paulodowd/RoboticsScienceAndSystems/README.md

# RoboticsScienceAndSystems
Platforms for teaching Robotics Science and Systems
