paulodowd/RoboticsScienceAndSystems/DigitalTwin/surface2.png

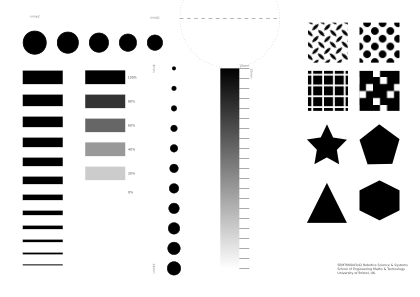
DigitalTwin/surface2.png
