paulodowd/RoboticsScienceAndSystems/DigitalTwin/surface.png

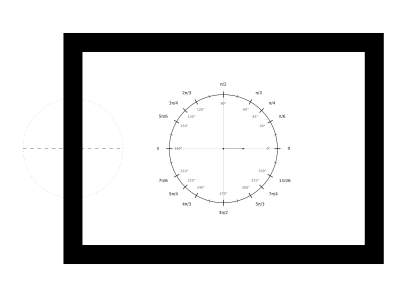
DigitalTwin/surface.png
