paulodowd/RoboticsScienceAndSystems/pcb/RSS_StampC3Extension/M5_Hardware-master/Products/K132_Cardputer/Structures/Cardputer_Button.stl

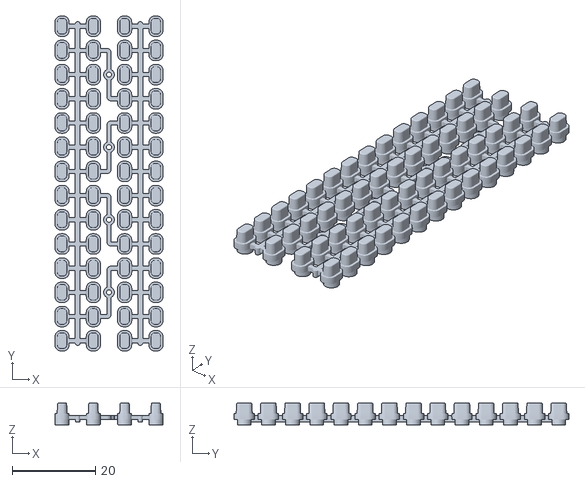
[picture p3: CAD file, 2026-10-30]
pcb/RSS_StampC3Extension/M5_Hardware-master/Products/K132_Cardputer/Structures/Cardputer_Button.stl
25.9 x 80.3 x 5.25
