paulodowd/RoboticsScienceAndSystems/pcb/RSS_StampC3Extension/RSS_StampC3Extension.pdf

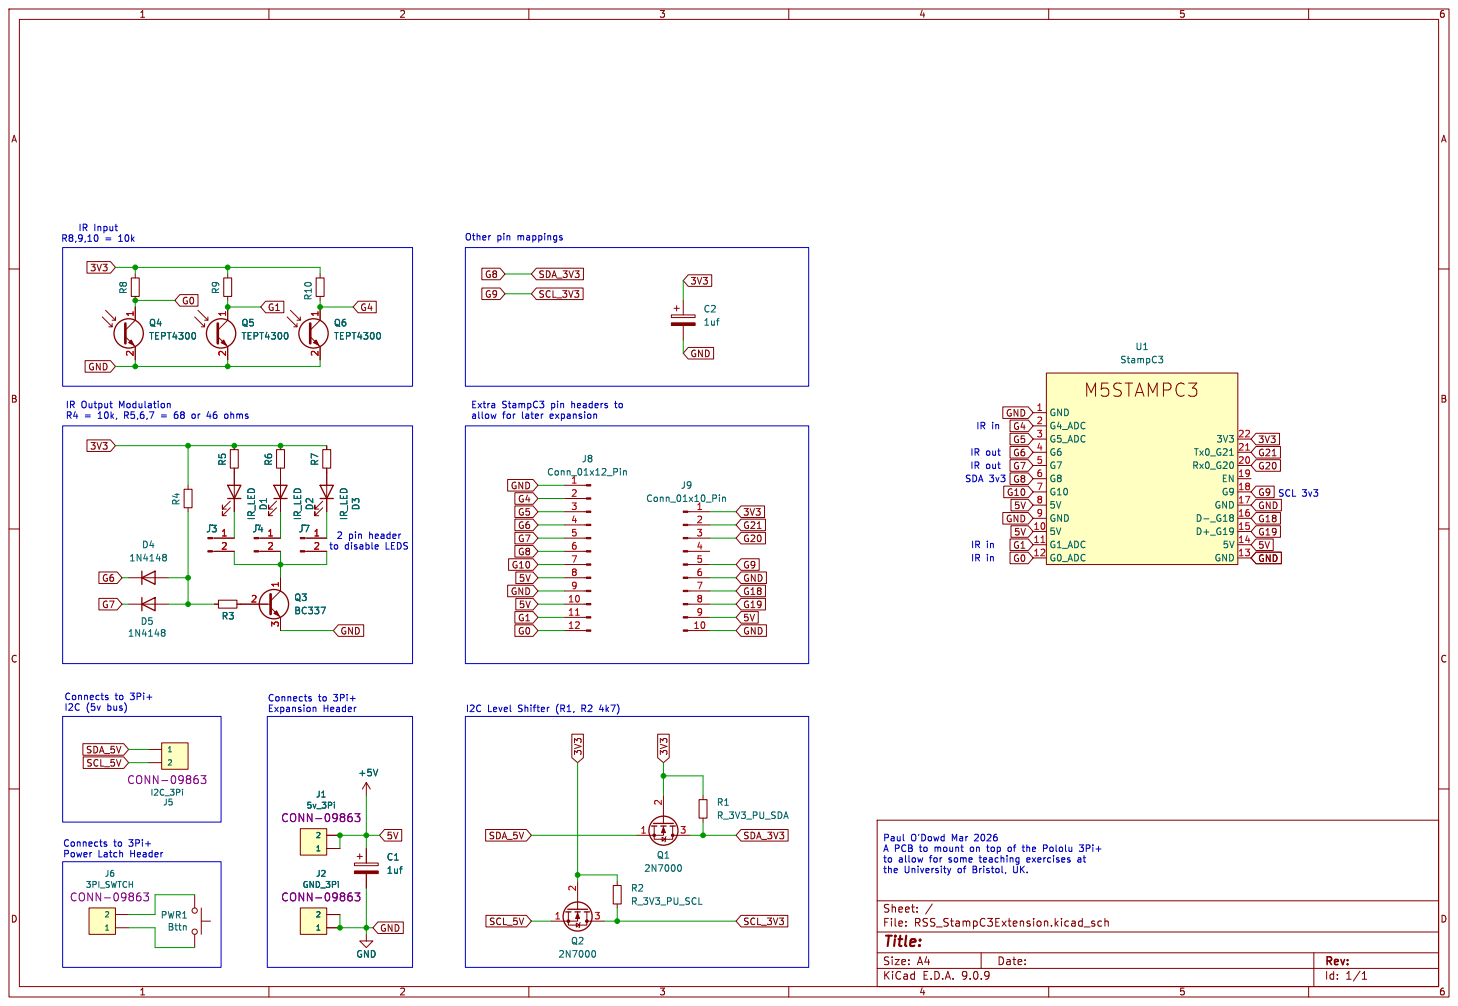
[picture p4: page 1]

IR Input R8,9,10 = 10k Connects to 3Pi+ Power Latch Header Connects to 3Pi+
3V3 SCL_5V

IR Output Modulation R4 = 10k, R5,6,7 = 68 or 46 ohms

IR out Extra StampC3 pin headers to
allow for later expansion

Id: 1/1 Title: File: RSS_StampC3Extension.kicad_sch Sheet: / +5V D1 IR_LED

IR in Paul O'Dowd Mar 2026 A PCB to mount on top of the Pololu 3Pi+
