paulodowd/RoboticsScienceAndSystems/(list of files, drawings)

Other design files:
pcb/RSS_StampC3Extension/M5_Hardware-master/Common/Module13.2/Footprints/Module13.2_Proto_Board.PcbDoc
pcb/RSS_StampC3Extension/M5_Hardware-master/Common/Module_Type_A/Footprints/Module_Type_A_CoreS3_M5_Bus.PcbDoc
pcb/RSS_StampC3Extension/M5_Hardware-master/Products/M001_Module_Proto/Footprints/Module_Proto_Board.PcbDoc
pcb/RSS_StampC3Extension/M5_Hardware-master/Products/S015_Stamp-S3Bat/Footprint/Stamp-S3Bat_SMD.PcbDoc
