paulodowd/RoboticsScienceAndSystems/pcb/RSS_StampC3Extension/RSS_StampC3Extension.kicad_pcb

## KiCad design pcb/RSS_StampC3Extension/RSS_StampC3Extension.kicad_pcb (2026-10-30)

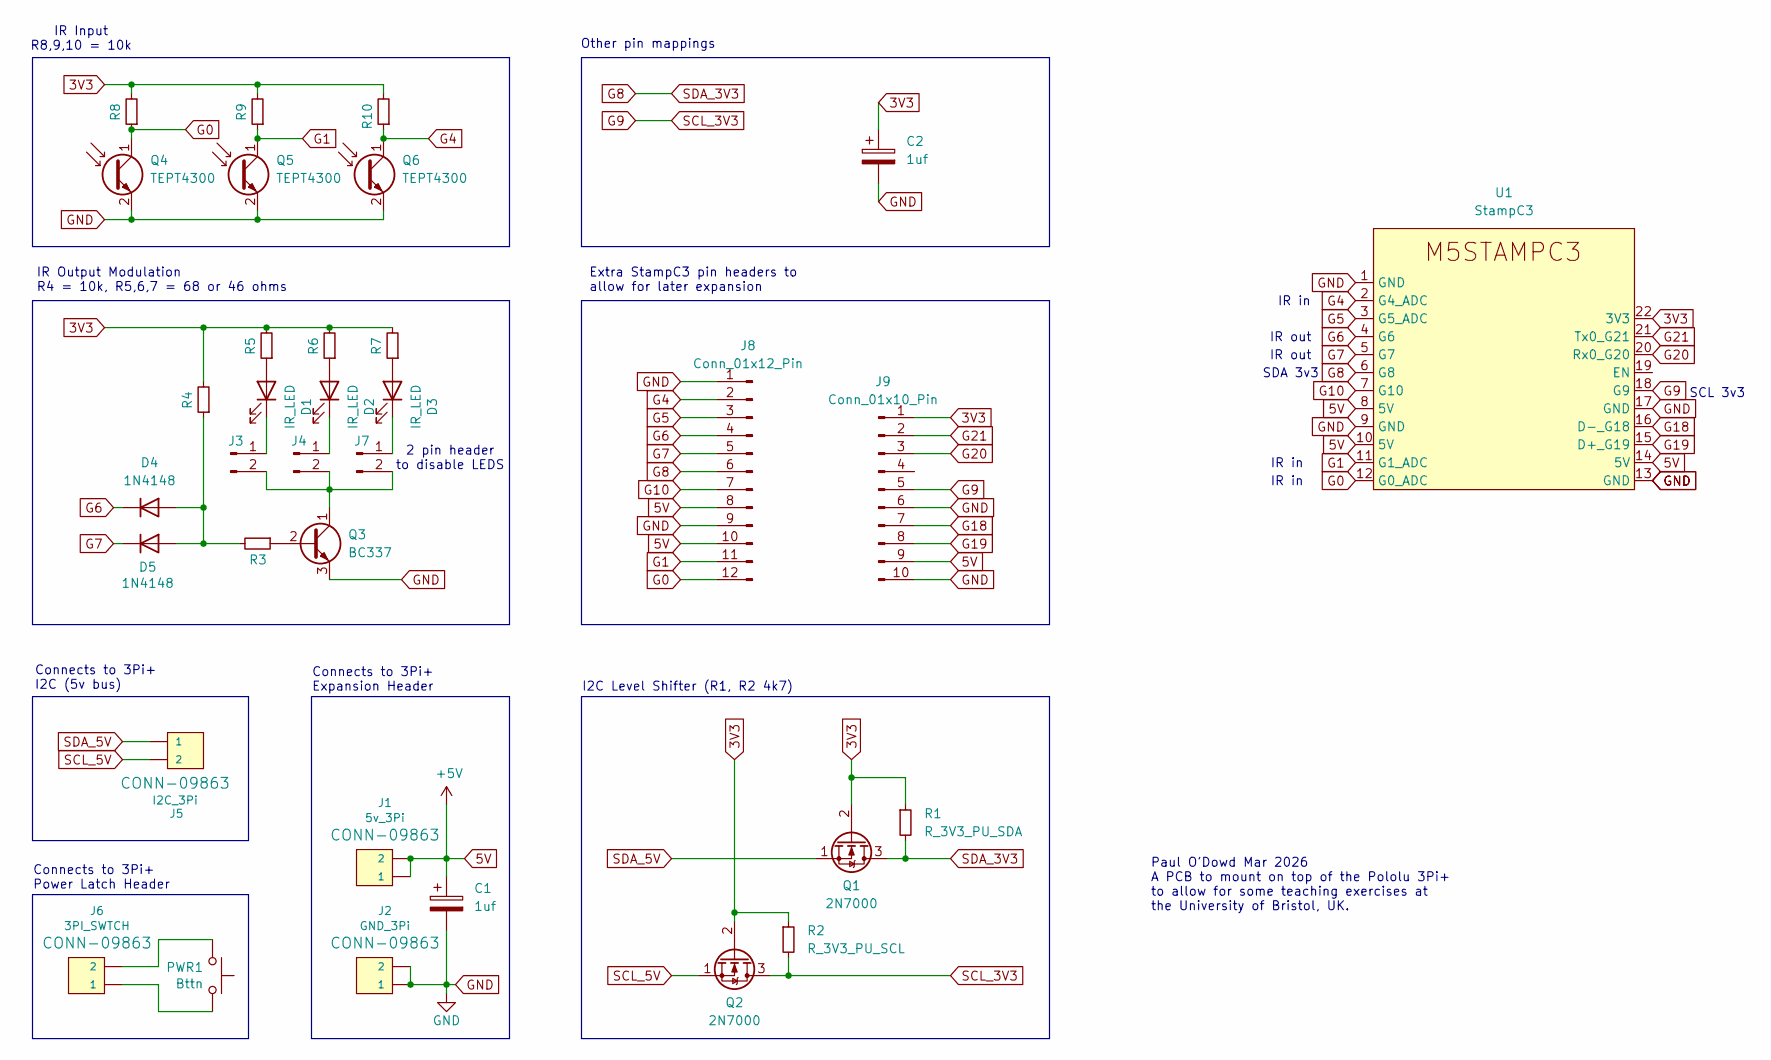
[picture p5: schematic RSS_StampC3Extension.kicad_sch]

Parts:
C1, C2: 1uf; CP_Radial_D5.0mm_P2.00mm
D1, D2, D3: IR_LED; LED_D3.0mm_Horizontal_O1.27mm_Z2.0mm
D4, D5: 1N4148; D_DO-35_SOD27_P7.62mm_Horizontal
J1: 5v_3Pi; PinHeader_1x02_P2.54mm_Vertical
J2: GND_3Pi; PinHeader_1x02_P2.54mm_Vertical
J3, J4, J7: PinHeader_1x02_P2.54mm_Vertical
J5: I2C_3Pi; PinHeader_1x02_P2.54mm_Vertical
J6: 3PI_SWTCH; PinHeader_1x02_P2.54mm_Vertical
J8: Conn_01x12_Pin; PinHeader_1x12_P2.54mm_Vertical
J9: Conn_01x10_Pin; PinHeader_1x10_P2.54mm_Vertical
PWR1: Bttn; SW_PUSH_6mm
Q1, Q2: 2N7000; TO-92_Inline
Q3: BC337; TO-92_Inline
Q4, Q5, Q6: TEPT4300; LED_D3.0mm_Clear
R1: R_3V3_PU_SDA; R_Axial_DIN0207_L6.3mm_D2.5mm_P10.16mm_Horizontal
R2: R_3V3_PU_SCL; R_Axial_DIN0207_L6.3mm_D2.5mm_P10.16mm_Horizontal
R3, R4, R5, R6, R7, R8, R9, R10: R_Axial_DIN0207_L6.3mm_D2.5mm_P10.16mm_Horizontal
U1: StampC3; Stamp-C3

Connections:
3V3: C2.1, J9.1, Q1.2 (G), Q2.2 (G), R1.1, R2.1, R4.2, R5.2, R6.2, R7.2, R8.2, R9.2, R10.2, U1.22 (3V3)
5V: C1.1, J1.1, J1.2, J8.8, J8.10, J9.9, U1.8 (5V), U1.10 (5V), U1.14 (5V)
G0: J8.12, Q4.1 (C), R8.1, U1.12 (G0_ADC)
G1: J8.11, Q5.1 (C), R9.1, U1.11 (G1_ADC)
G4: J8.2, Q6.1 (C), R10.1, U1.2 (G4_ADC)
G5: J8.3, U1.3 (G5_ADC)
G6: D4.1 (K), J8.4, U1.4 (G6)
G7: D5.1 (K), J8.5, U1.5 (G7)
G8: J8.6, Q1.3 (D), R1.2, U1.6 (G8)
G9: J9.5, Q2.3 (D), R2.2, U1.18 (G9)
G10: J8.7, U1.7 (G10)
G18: J9.7, U1.16 (D-_G18)
G19: J9.8, U1.15 (D+_G19)
G20: J9.3, U1.20 (Rx0_G20)
G21: J9.2, U1.21 (Tx0_G21)
GND: C1.2, C2.2, J2.1, J2.2, J8.1, J8.9, J9.6, J9.10, Q3.3 (E), Q4.2 (E), Q5.2 (E), Q6.2 (E), U1.1 (GND), U1.9 (GND), U1.13 (GND), U1.17 (GND)
unnamed: D1.2 (A), R5.1
unnamed: D1.1 (K), J3.1
unnamed: D2.2 (A), R6.1
unnamed: D2.1 (K), J4.1
unnamed: D3.2 (A), R7.1
unnamed: D3.1 (K), J7.1
unnamed: D4.2 (A), D5.2 (A), R3.2, R4.1
unnamed: J3.2, J4.2, J7.2, Q3.1 (C)
unnamed: J6.1, PWR1.1
unnamed: J6.2, PWR1.2
unnamed: Q3.2 (B), R3.1
SCL_5V: J5.2, Q2.1 (S)
SDA_5V: J5.1, Q1.1 (S)

Notes on the sheet:
IR out
IR in
2 pin header to disable LEDS
Paul O'Dowd Mar 2026 A PCB to mount on top of the Pololu 3Pi+ to allow for some teaching exercises at the University of Bristol, UK.
IR Input R8,9,10 = 10k
I2C Level Shifter (R1, R2 4k7)
IR Output Modulation R4 = 10k, R5,6,7 = 68 or 46 ohms
Connects to 3Pi+ I2C (5v bus)
Extra StampC3 pin headers to allow for later expansion
Connects to 3Pi+ Expansion Header
SDA 3v3
SCL 3v3
Connects to 3Pi+ Power Latch Header
Other pin mappings

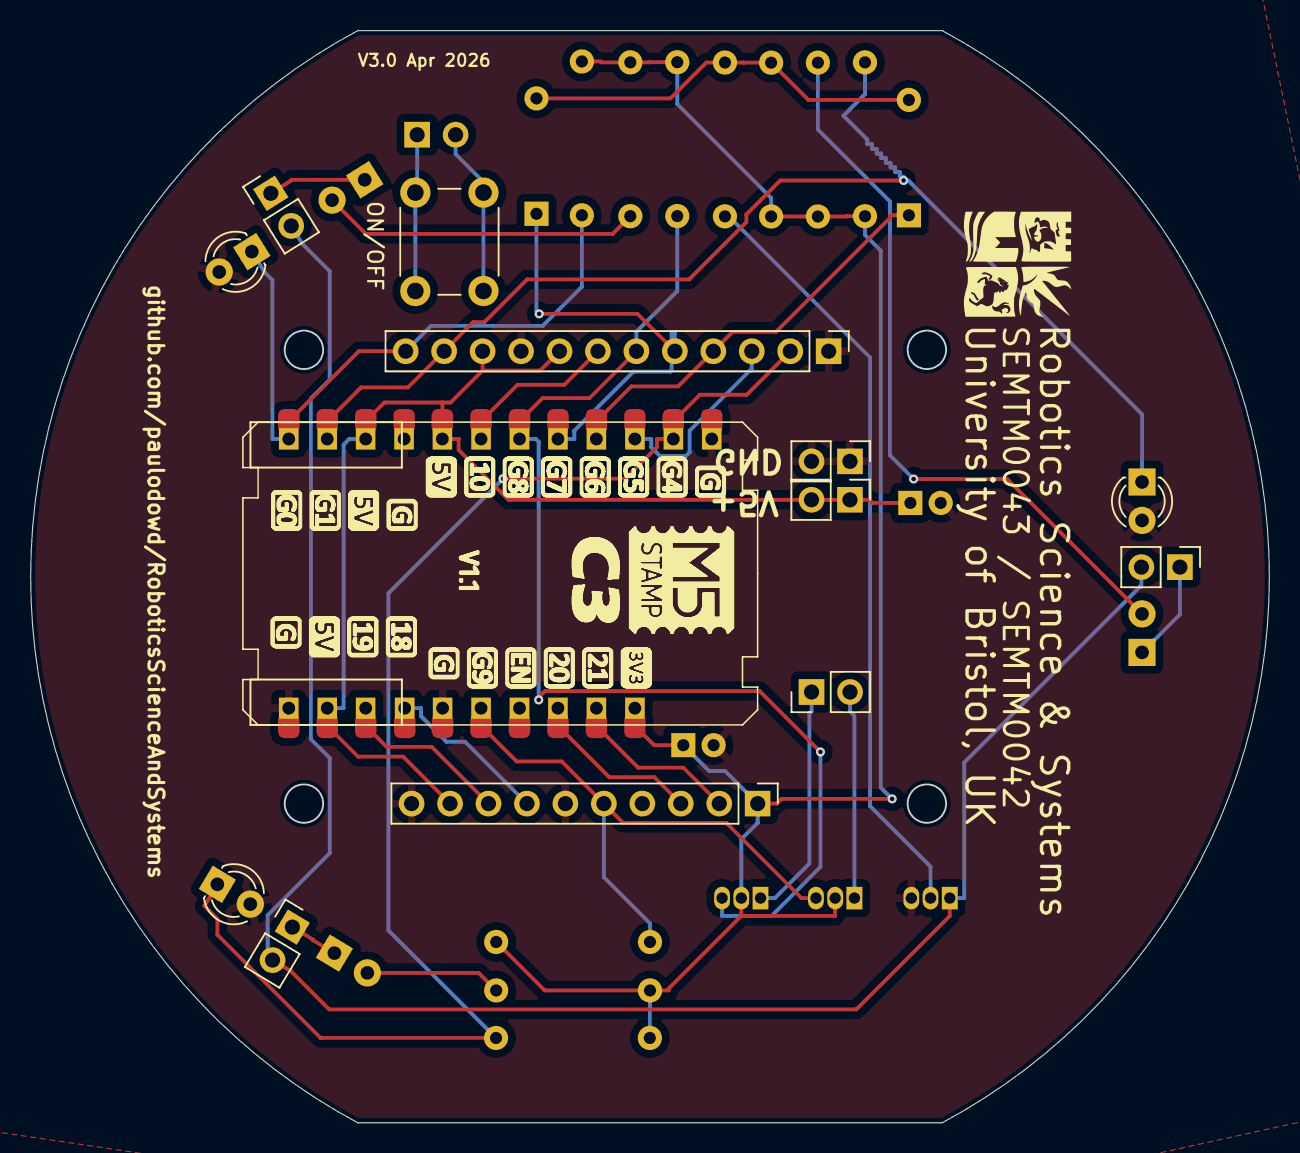
[picture p6: board RSS_StampC3Extension.kicad_pcb from above]

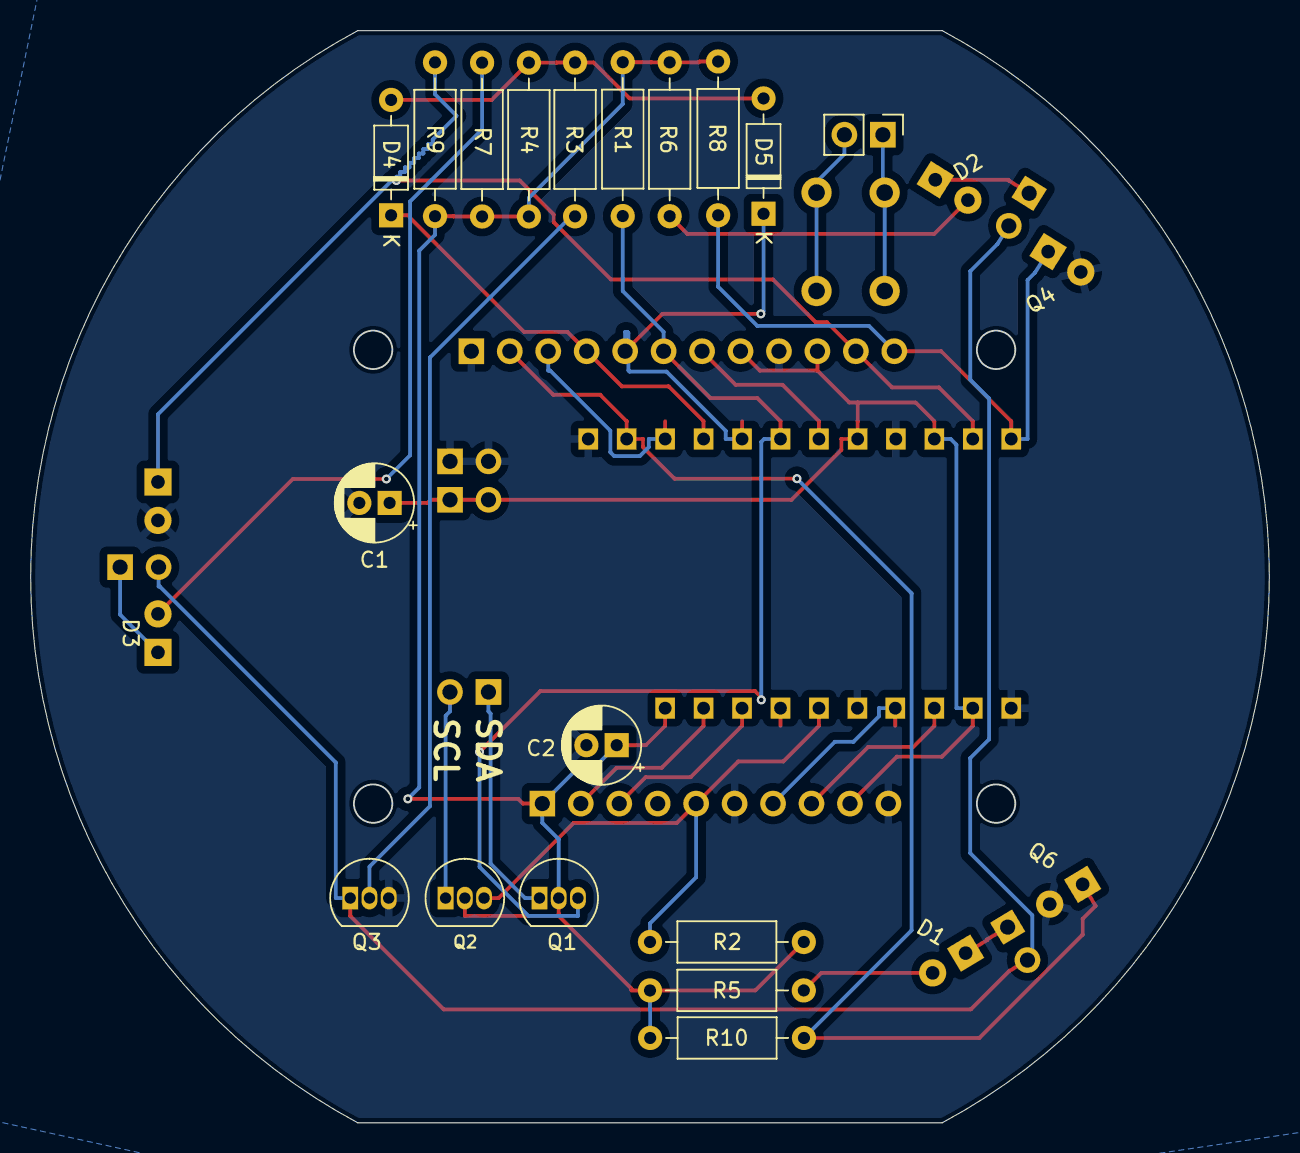
[picture p7: board RSS_StampC3Extension.kicad_pcb from below]

Board: 2 copper layers, 81.8 x 72.1 mm, 34 parts (18 on the bottom side), 29 nets.
