paulodowd/RoboticsScienceAndSystems/(commit log)

2026-10-27 added image of reverse side of printable test map
2026-10-30 added pcb files
